R-Mutura/Qi_charger_mini/IMAGES/image 3.png

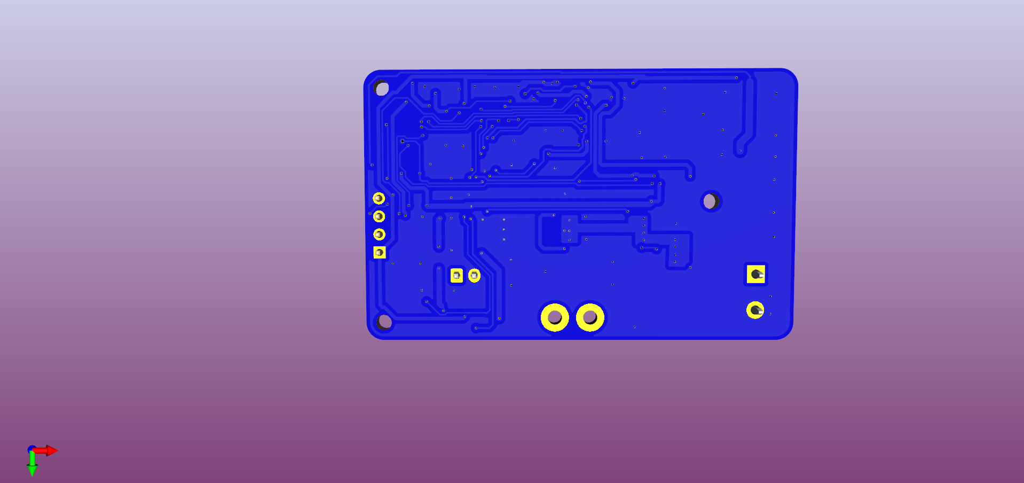
IMAGES/image 3.png
