R-Mutura/Qi_charger_mini/IMAGES/image 4.png

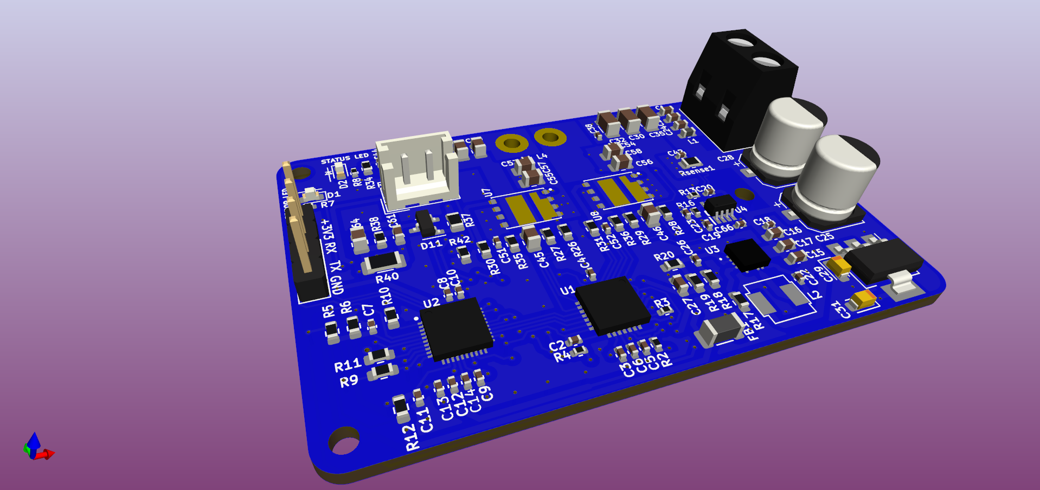
IMAGES/image 4.png
