R-Mutura/Qi_charger_mini/README.md

# The_Qi_wireless_charger_tx
This repo contains the design files for the Qi wireless charger.
