R-Mutura/Qi_charger_mini/FILES/recomended TX Coil.PNG

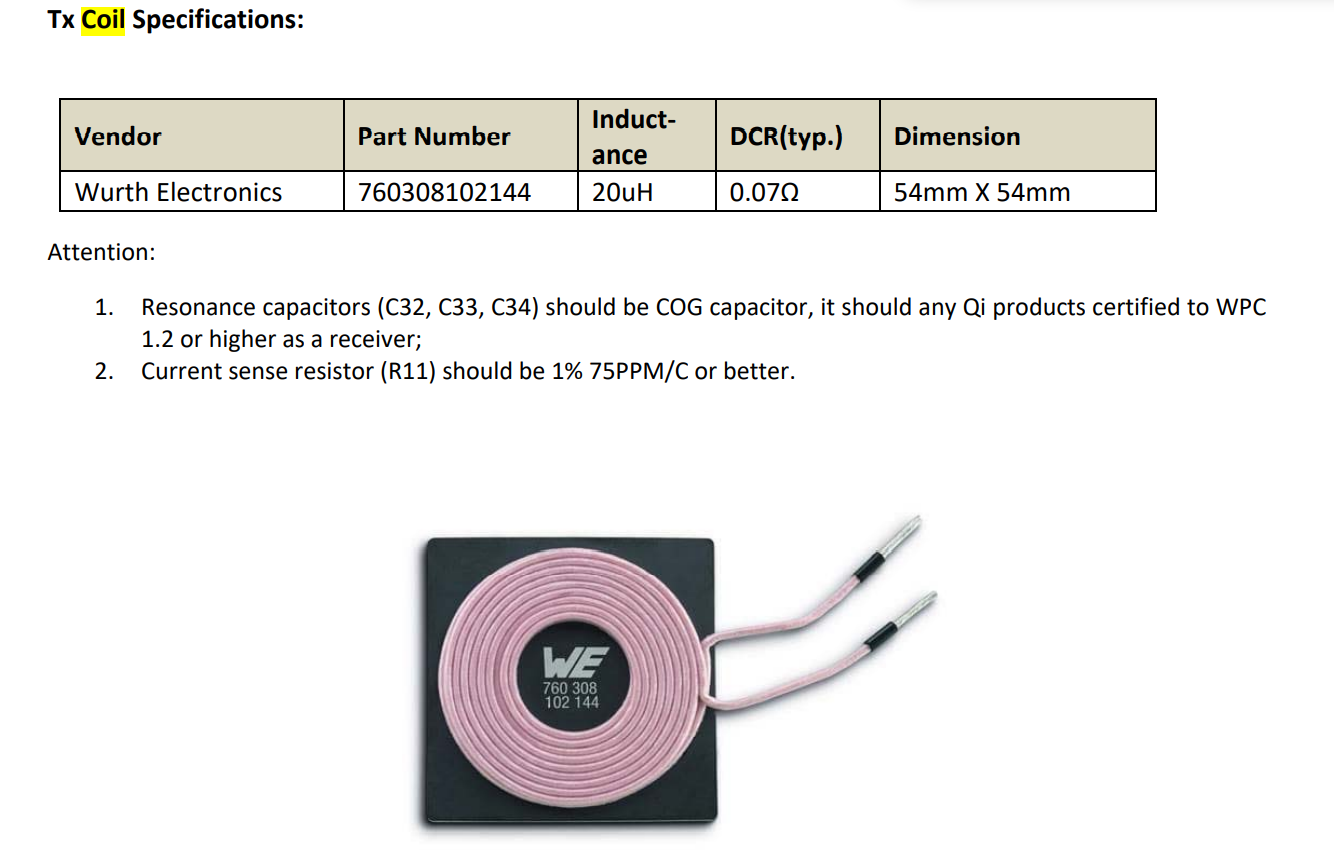
FILES/recomended TX Coil.PNG
