R-Mutura/Qi_charger_mini/IMAGES/image 1.png

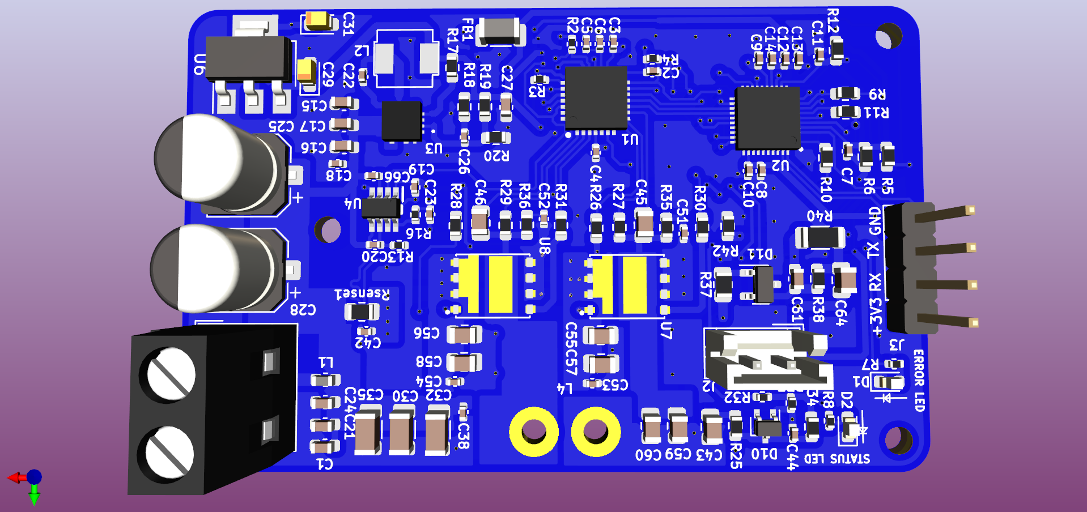
IMAGES/image 1.png
