R-Mutura/Qi_charger_mini/IMAGES/image 2.png

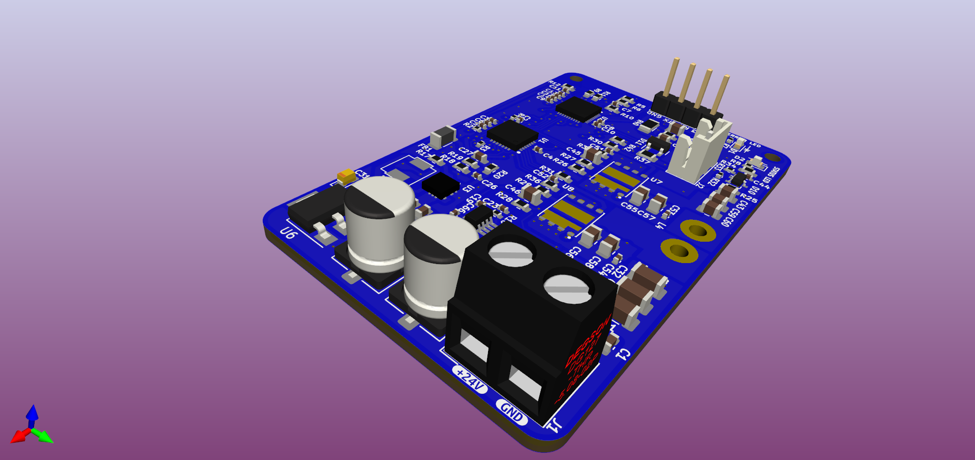
IMAGES/image 2.png
