R-Mutura/Qi_charger_mini/IMAGES/layout 1.PNG

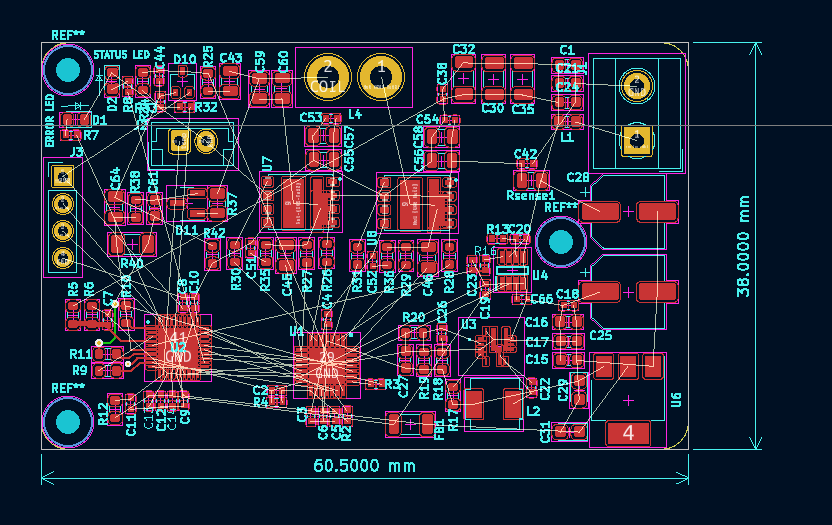
IMAGES/layout 1.PNG
