R-Mutura/Qi_charger_mini/BOM/Qi_wireless_charger_BOM(1).xlsx

Reference | Value | Footprint | MPN | Vendor | QTY
C1, C21 | 100nF | Capacitor_SMD:C_0603_1608Metric | 0603B104K500NT | LCSC | 2
C2 | 47pF | Capacitor_SMD:C_0402_1005Metric | CC0402JRNPO9BN470 | LCSC | 1
C4, C9-C11, C13, C14, C23 | 100nF | Capacitor_SMD:C_0402_1005Metric | CC0402JRNPO9BN470 | LCSC | 7
C5, C7, C8, C12 | 4.7uF | Capacitor_SMD:C_0402_1005Metric | CL05A475KP5NRNC | LCSC | 4
C3, C6, C66 | 10nF | Capacitor_SMD:C_0402_1005Metric | CL05B103KB5NNNC | LCSC | 3
C15-C17 | 4.7uF | Capacitor_SMD:C_0603_1608Metric | CL10A475KL8NRNC | LCSC | 3
C18 | 100nF_20mOHM | Capacitor_SMD:C_0402_1005Metric | CC0402JRNPO9BN470 | DigiKey | 1
C19 | 10nF_10V | Capacitor_SMD:C_0402_1005Metric | CL05B103KB5NNNC | LCSC | 1
C20 | 1uF | Capacitor_SMD:C_0402_1005Metric | CL05A105KP5NNNC | LCSC | 1
C22 | 100nF_1mOHM | Capacitor_SMD:C_0402_1005Metric | CC0402KRX7R7BB104 | LCSC | 1
C24 | 10nF | Capacitor_SMD:C_0603_1608Metric | 0603B104K500NT | LCSC | 1
C26 | 100pF | Capacitor_SMD:C_0402_1005Metric | CC0402KRX7R7BB104 | LCSC | 1
C27 | 47uF_3.70mOHM | Capacitor_SMD:C_0603_1608Metric | GRM188R60J476ME15D | LCSC | 1
C25, C28 | 100uF | Capacitor_SMD:CP_Elec_6.3x7.7 | VZT101M1HTR-0607 | LCSC | 2
C29, C31 | 10uF | Capacitor_Tantalum_SMD:CP_EIA-2012-12_Kemet-R | TAJR106K006RNJ | LCSC | 2
C30, C32, C35 | 22uF_35V | Capacitor_SMD:C_1206_3216Metric | C3216X5R1V226MTJ00E | LCSC | 3
C38, C53, C54 | 100nF_50V | Capacitor_SMD:C_0402_1005Metric | 0402F104M500NT | LCSC | 3
C42 | 100nF>50V | Capacitor_SMD:C_0402_1005Metric | 0402F104M500NT | LCSC | 1
C43 | 4.7nF_150V | Capacitor_SMD:C_0805_2012Metric | C0805C472K2RECAUTO | DigiKey | 1
C44 | 33pF | Capacitor_SMD:C_0402_1005Metric | CC0805JRNPOABN330 | DigiKey | 1
C51, C52 | 2.7nF | Capacitor_SMD:C_0402_1005Metric | 0402B272K500NT | LCSC | 2
C55-C58 | 22uF_35V | Capacitor_SMD:C_0805_2012Metric | C3216X5R1V226MTJ00E | LCSC | 4
C45, C46, C59, C60 | 47nF_250V | Capacitor_SMD:C_0805_2012Metric | C2012X7T2E473KT000N | LCSC | 4
C61 | 1nF_150V | Capacitor_SMD:C_0603_1608Metric | 0603B102K201CT | LCSC | 1
C64 | 100nF_150V | Capacitor_SMD:C_0805_2012Metric | FM21X104K201ECG | LCSC | 1
D1 | LED_RED | LED_SMD:LED_0603_1608Metric | SZYY0603R | LCSC | 1
D2 | LED_GREEN | LED_SMD:LED_0603_1608Metric | XZVGMDK53W-9 | LCSC | 1
D10 | BAT54SW_SERIES | Package_TO_SOT_SMD:SOT-323_SC-70 | BAT60B | LCSC | 1
D11 | MMBD7000HS | Package_TO_SOT_SMD:SOT-23 | MMBD7000HS | DigiKey | 1
FB1 | MLB3216-600P4A(f)_1206 | Inductor_SMD:L_1206_3216Metric | MLB3216-600P4A(f) | LCSC | 1
J1 | Screw_Terminal_01x02 | TerminalBlock_MetzConnect:TerminalBlock_MetzConnect_Type101_RT01602HBWC_1x02_P5.08mm_Horizontal | DB128L-5.08-2P-GN-P | LCSC | 1
J2 | THERMISTER_TEMP_IN | Connector_JST:JST_EH_B2B-EH-A_1x02_P2.50mm_Vertical | B2B-XH-A(LF)(SN) |  | 1
J3 | UART_SERIAL_CONN | Connector_PinHeader_2.54mm:PinHeader_1x04_P2.54mm_Vertical | B-2100S04P-A110 | LCSC | 1
L1 | BLM18SN220TH1D | Inductor_SMD:L_0603_1608Metric | BLM18SN220TH1D | LCSC | 1
L2 | MWSA0402S-3R3MT | greencharge-footprints:MWSA0402-xxx | MWSA0402S-3R3MT | DigiKey | 1
R2, R32, R33 | 7.5K | Resistor_SMD:R_0402_1005Metric | RC-02W1003FT | LCSC | 3
R3, R4 | 100K | Resistor_SMD:R_0402_1005Metric | RS-06K1003FT | LCSC | 2
R5, R11 | 100K | Resistor_SMD:R_0603_1608Metric | RC0603FR-07100KL | LCSC | 2
R6 | 11.5K | Resistor_SMD:R_0603_1608Metric | 0603WAF1152T5E | LCSC | 1
R7, R8 | 150 | Resistor_SMD:R_0402_1005Metric | 0402WGF1500TCE | LCSC | 2
R10 | 47K | Resistor_SMD:R_0603_1608Metric | 0603WAF4702T5E | LCSC | 1
R13 | 10R | Resistor_SMD:R_0402_1005Metric | 0402WGF1000TCE | LCSC | 1
R16 | 1.37K | Resistor_SMD:R_0402_1005Metric | 0402WGF1371TCE | LCSC | 1
R17, R38 | 100K_1% | Resistor_SMD:R_0603_1608Metric | RC0603FR-07100KL | LCSC | 2
R18 | 20K | Resistor_SMD:R_0603_1608Metric | 0603WAF2002T5E | LCSC | 1
R19 | 73.2K | Resistor_SMD:R_0603_1608Metric | ERJ3EKF7322V | LCSC | 1
R12, R20 | 10K | Resistor_SMD:R_0603_1608Metric | RC0603JR-0710KL | LCSC | 2
R25 | 200K | Resistor_SMD:R_0603_1608Metric | RC0603FR-07200KL | LCSC | 1
R27, R29 | 1 ohm | Resistor_SMD:R_0603_1608Metric | 0603WAF100KT5E | LCSC | 2
R35, R36 | 2 ohm | Resistor_SMD:R_0603_1608Metric | 0603WAF200KT5E | LCSC | 2
R37 | 7.5K | Resistor_SMD:R_0805_2012Metric | 0805W8F7501T5E | LCSC | 1
R40 | 1.5K | Resistor_SMD:R_1206_3216Metric | 1206W4J0102T5E | LCSC | 1
R9, R26, R28, R30, R31, R34, R42 | 0Ohm | Resistor_SMD:R_0603_1608Metric | 0603WAF0000T5E | LCSC | 7
Rsense1 | 0.01R_1% | Resistor_SMD:R_0805_2012Metric | RTT03R010JTP | LCSC | 1
U1 | TS61002 | greencharge-footprints:QFN50P500X500X100-29N | TS61002-QFNR | Mouser | 1
U2 | TS80003 | greencharge-footprints:QFN40P500X500X90-41N-D | TS80003-QFNR | Mouser | 1
U3 | TPS56637RPAR | greencharge-footprints:TPS56637RPAR | TPS56637RPAR | Digipart | 1
U4 | TS94033 | greencharge-footprints:SOT65P280X145-8N | TS94033 | Digipart | 1
U6 | AMS1117-3.3 | Package_TO_SOT_SMD:SOT-223-3_TabPin2 | AMS1117-3.3 | LCSC | 1
U7, U8 | BSC0993ND | greencharge-footprints:BSC0993ND | BSC0993NDATMA1 | Mouser | 2
