R-Mutura/Qi_charger_mini/FILES/ITEMS_RECOMENDATION.xlsx

NAME/ITEM | MFR#1 | LINKS | PRICE | MFR#2 | LINK_2 | PRICE_2 | MFR#3 | LINK_3 | PRICE_3
DISPLAY | 5inch AMOLED Display | https://www.globalsources.com/AMOLED-display/5inch-AMOLED-Display-1163260034p.htm | 42/pcs | 5.5 inch AMOLED Screen MIPI flexible oled | https://www.alibaba.com/product-detail/Amoled-Mipi-5-5-Inch-AMOLED_11000000463560.html?s=p | 28 | OEM 5 inch AMOLED TFT module display | https://www.alibaba.com/product-detail/LCD-TFT-module-driver-board-7_1600217797913.html | 34.54
DISPLAY DRIVER(SPI-MIPI) | 1024x600 40PIN 50PIN IPS 7" | https://www.digipart.com/part/TC358768AXBG(EL) | 3.594
TRANSMIT COIL(RX) | Qi A10 | https://hartai.en.made-in-china.com/product/NKLJYDcBnCVA/China-Qi-A10-Wireless-Charger-Tx-Coil-for-Mobile-Phone-Wireless-Charger.html | 0.4/PCS (100PCS) | Wireless charger coil A5 A6 A11 for Vishay Dale Electronics | https://www.alibaba.com/product-detail/43mm-Wireless-charger-coil-A5-A6_60228736673.html | 0.01/PCS (1000) | YX-A11-R501000-R0807 | https://lcsc.com/product-detail/Wireless-Charging-Coils_CND-tek-YX-A11-R501000-R0807-BEIJIAO_C424428.html | 0.3463
RECEVE COIL(RX) | Square Rx Coil(A5) | https://kimchen8.en.made-in-china.com/product/uBcmjaAlYKht/China-Square-Rx-Coil-Antenna-Coil-for-Samsung-Charging-Receiver.html | 0.465/PCS (500PCS) | YX-A11-R501000-R0807 | https://lcsc.com/product-detail/Wireless-Charging-Coils_CND-tek-YX-A11-R501000-R0807-BEIJIAO_C424428.html | 0.3463 | Coil Qi A5 | https://www.alibaba.com/product-detail/Charging-Coil-Wireless-Wireless-Charge-Coil_60568841665.html?s=p | 0.01/PCS (100)
RECEVE COIL(RX) | Another square coil | https://m.made-in-china.com/product/Qi-WPC-Charger-Inductive-Small-Capacitance-Wireless-Charging-Receiver-Rx-Coil-787279135.html | 0.2/pcs (20pcs)
BATTERY | high capacity 1160100(10Ah) | https://www.alibaba.com/product-detail/high-capacity-1160100-10000mah-3-7v_60740948993.html | 6.99 | 1090100 1S2P LiPO | https://www.alibaba.com/product-detail/High-capacity-lipo-battery-1090100-1S2P_60861781658.html | 11.66 | 6000mah 3.7V 806090 | https://www.alibaba.com/product-detail/high-capacity-lithium-ion-battery-6000mah_1600089017174.html | 5(pieces min)
