R-Mutura/Qi_charger_mini/src_files(1)/src_files/The_Qi_wireless_charger_tx.kicad_pcb

## KiCad design src_files(1)/src_files/The_Qi_wireless_charger_tx.kicad_pcb (2022-05-29)

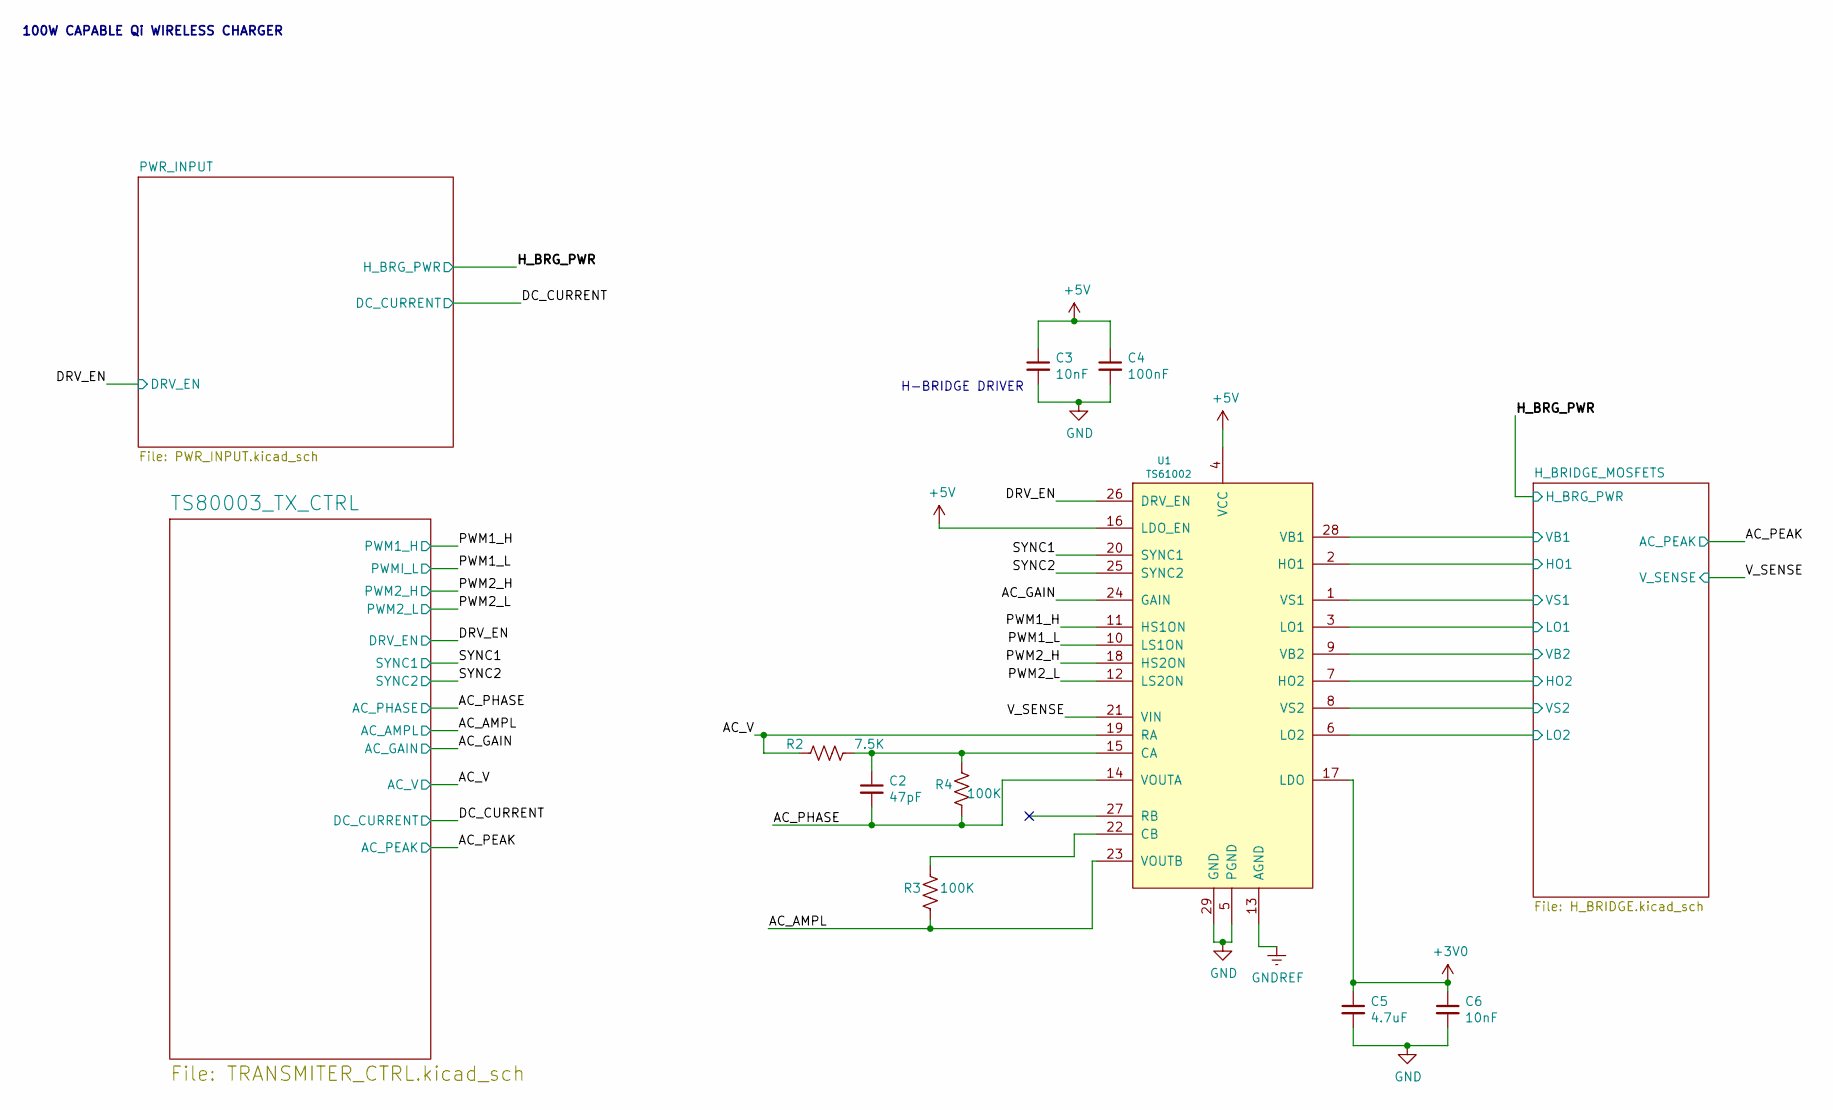
[picture p12: schematic The_Qi_wireless_charger_tx.kicad_sch]

Parts:
C2: 47pF; C_0402_1005Metric
C3, C6: 10nF; C_0402_1005Metric
C4: 100nF; C_0402_1005Metric
C5: 4.7uF; C_0402_1005Metric
R2: 7.5K; R_0402_1005Metric
R3, R4: 100K; R_0402_1005Metric
U1: TS61002; QFN50P500X500X100-29N

Connections:
+3V0: C5.1, C6.1, U1.17 (LDO)
+5V: C3.1, C4.1, U1.4 (VCC), U1.16 (LDO_EN); also elsewhere on the board
/AC_AMPL: R3.2, U1.23 (VOUTB); also elsewhere on the board
/AC_GAIN: U1.24 (GAIN); also elsewhere on the board
/AC_PHASE: C2.2, R4.2, U1.14 (VOUTA); also elsewhere on the board
/AC_V: R2.1, U1.19 (RA); also elsewhere on the board
/DRV_EN: U1.26 (DRV_EN); also elsewhere on the board
/H_BRIDGE_MOSFETS/HO1: U1.2 (HO1); also elsewhere on the board
/H_BRIDGE_MOSFETS/HO2: U1.7 (HO2); also elsewhere on the board
/H_BRIDGE_MOSFETS/LO1: U1.3 (LO1); also elsewhere on the board
/H_BRIDGE_MOSFETS/LO2: U1.6 (LO2); also elsewhere on the board
/H_BRIDGE_MOSFETS/VB1: U1.28 (VB1); also elsewhere on the board
/H_BRIDGE_MOSFETS/VB2: U1.9 (VB2); also elsewhere on the board
/H_BRIDGE_MOSFETS/VS1: U1.1 (VS1); also elsewhere on the board
/H_BRIDGE_MOSFETS/VS2: U1.8 (VS2); also elsewhere on the board
/PWM1_H: U1.11 (HS1ON); also elsewhere on the board
/PWM1_L: U1.10 (LS1ON); also elsewhere on the board
/PWM2_H: U1.18 (HS2ON); also elsewhere on the board
/PWM2_L: U1.12 (LS2ON); also elsewhere on the board
/SYNC1: U1.20 (SYNC1); also elsewhere on the board
/SYNC2: U1.25 (SYNC2); also elsewhere on the board
/V_SENSE: U1.21 (VIN); also elsewhere on the board
GND: C3.2, C4.2, C5.2, C6.2, U1.5 (PGND), U1.29 (GND); also elsewhere on the board
GNDREF: U1.13 (AGND); also elsewhere on the board
unnamed: C2.1, R2.2, R4.1, U1.15 (CA)
unnamed: R3.1, U1.22 (CB)

Notes on the sheet:
100W CAPABLE Qi WIRELESS CHARGER
H-BRIDGE DRIVER

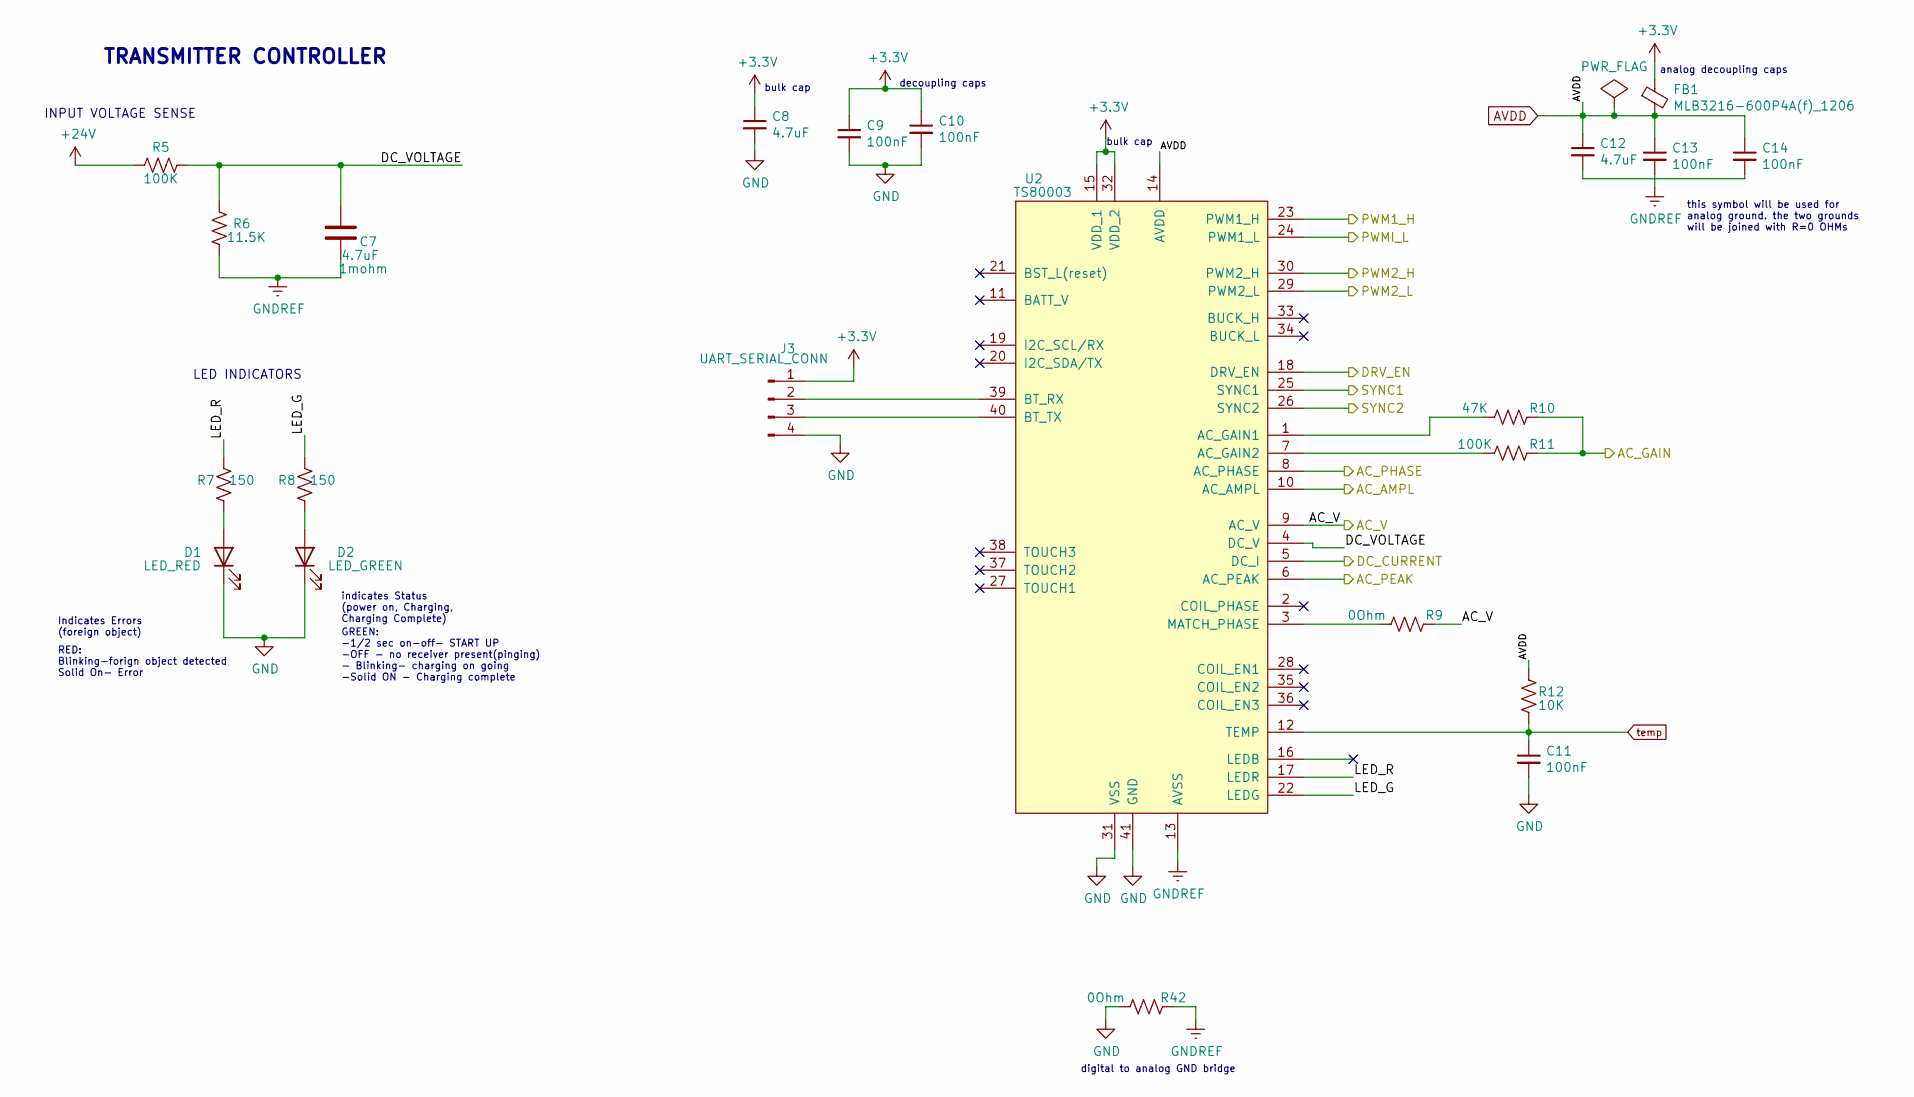
[picture p13: schematic TRANSMITER_CTRL.kicad_sch]

Parts:
C7, C8, C12: 4.7uF; C_0402_1005Metric
C9, C10, C11, C13, C14: 100nF; C_0402_1005Metric
D1: LED_RED; LED_0603_1608Metric
D2: LED_GREEN; LED_0603_1608Metric
FB1: MLB3216-600P4A(f)_1206; L_1206_3216Metric
J3: UART_SERIAL_CONN; PinHeader_1x04_P2.54mm_Vertical
R5, R11: 100K; R_0603_1608Metric
R6: 11.5K; R_0603_1608Metric
R7, R8: 150; R_0402_1005Metric
R9, R42: 0Ohm; R_0603_1608Metric
R10: 47K; R_0603_1608Metric
R12: 10K; R_0603_1608Metric
U2: TS80003; QFN40P500X500X90-41N-D

Connections:
+3V3: C8.1, C9.1, C10.1, FB1.1, J3.1, U2.15 (VDD_1), U2.32 (VDD_2); also elsewhere on the board
+24V: R5.2; also elsewhere on the board
/AC_AMPL: U2.10 (AC_AMPL); also elsewhere on the board
/AC_GAIN: R10.1, R11.1; also elsewhere on the board
/AC_PEAK: U2.6 (AC_PEAK); also elsewhere on the board
/AC_PHASE: U2.8 (AC_PHASE); also elsewhere on the board
/AC_V: R9.1, U2.9 (AC_V); also elsewhere on the board
/DC_CURRENT: U2.5 (DC_I); also elsewhere on the board
/DRV_EN: U2.18 (DRV_EN); also elsewhere on the board
/PWM1_H: U2.23 (PWM1_H); also elsewhere on the board
/PWM1_L: U2.24 (PWM1_L); also elsewhere on the board
/PWM2_H: U2.30 (PWM2_H); also elsewhere on the board
/PWM2_L: U2.29 (PWM2_L); also elsewhere on the board
/SYNC1: U2.25 (SYNC1); also elsewhere on the board
/SYNC2: U2.26 (SYNC2); also elsewhere on the board
/TS80003_TX_CTRL/DC_VOLTAGE: C7.1, R5.1, R6.2, U2.4 (DC_V)
/TS80003_TX_CTRL/LED_G: R8.1, U2.22 (LEDG)
/TS80003_TX_CTRL/LED_R: R7.1, U2.17 (LEDR)
AVDD: C12.1, C13.1, C14.1, FB1.2, R12.1, U2.14 (AVDD); also elsewhere on the board
GND: C8.2, C9.2, C10.2, C11.2, D1.1 (K), D2.1 (K), J3.4, R42.2, U2.31 (VSS), U2.41 (GND); also elsewhere on the board
GNDREF: C7.2, C13.2, R6.1, R42.1, U2.13 (AVSS); also elsewhere on the board
unnamed: C12.2, C14.2
unnamed: D1.2 (A), R7.2
unnamed: D2.2 (A), R8.2
unnamed: J3.2, U2.39 (BT_RX)
unnamed: J3.3, U2.40 (BT_TX)
unnamed: R9.2, U2.3 (MATCH_PHASE)
unnamed: R10.2, U2.1 (AC_GAIN1)
unnamed: R11.2, U2.7 (AC_GAIN2)
temp: C11.1, R12.2, U2.12 (TEMP); also elsewhere on the board

Notes on the sheet:
TRANSMITTER CONTROLLER
INPUT VOLTAGE SENSE
indicates Status (power on, Charging, Charging Complete)
digital to analog GND bridge
LED INDICATORS
analog decoupling caps
this symbol will be used for analog ground. the two grounds will be joined with R=0 OHMs
bulk cap
RED: Blinking-forign object detected Solid On- Error
decoupling caps
GREEN: -1/2 sec on-off- START UP -OFF - no receiver present(pinging) - Blinking- charging on going -Solid ON - Charging complete
Indicates Errors (foreign object)

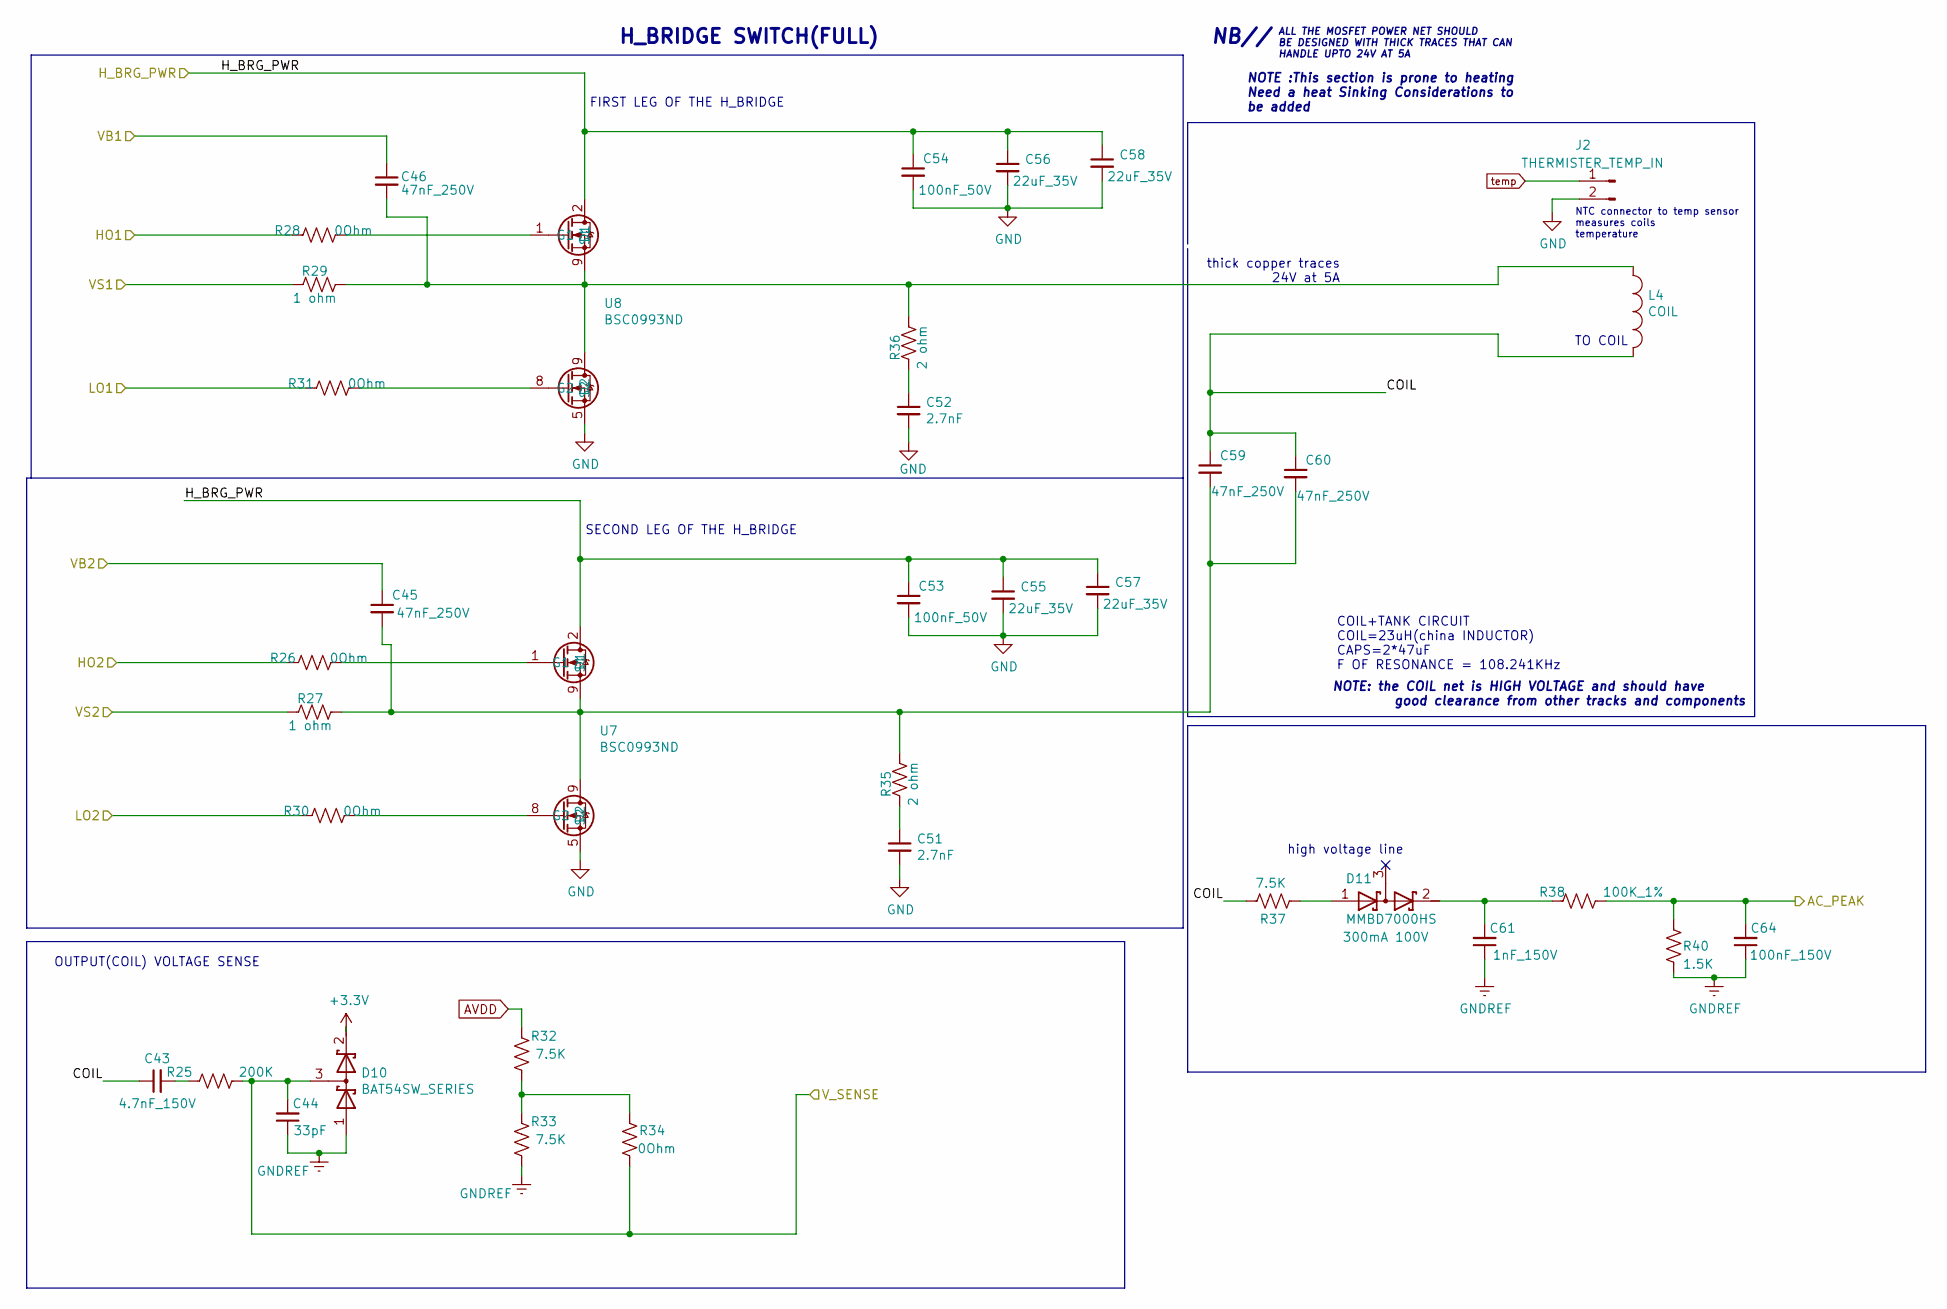
[picture p14: schematic H_BRIDGE.kicad_sch]

Parts:
C43: 4.7nF_150V; C_0805_2012Metric
C44: 33pF; C_0402_1005Metric
C45, C46, C59, C60: 47nF_250V; C_0805_2012Metric
C51, C52: 2.7nF; C_0402_1005Metric
C53, C54: 100nF_50V; C_0402_1005Metric
C55, C56, C57, C58: 22uF_35V; C_0805_2012Metric
C61: 1nF_150V; C_0603_1608Metric
C64: 100nF_150V; C_0805_2012Metric
D10: BAT54SW_SERIES; SOT-323_SC-70
D11: MMBD7000HS; SOT-23
J2: THERMISTER_TEMP_IN; JST_EH_B2B-EH-A_1x02_P2.50mm_Vertical
L4: COIL; coil_760308102144
R25: 200K; R_0603_1608Metric
R26, R28, R30, R31, R34: 0Ohm; R_0603_1608Metric
R27, R29: 1 ohm; R_0603_1608Metric
R32, R33: 7.5K; R_0402_1005Metric
R35, R36: 2 ohm; R_0603_1608Metric
R37: 7.5K; R_0805_2012Metric
R38: 100K_1%; R_0603_1608Metric
R40: 1.5K; R_1206_3216Metric
U7, U8: BSC0993ND

Connections:
+3V3: D10.2 (K); also elsewhere on the board
/AC_PEAK: C64.2, R38.2, R40.2; also elsewhere on the board
/H_BRG_PWR: C53.1, C54.1, C55.1, C56.1, C57.1, C58.1, U7.2 (D1), U7.3 (D1), U7.4 (D1), U8.2 (D1), U8.3 (D1), U8.4 (D1); also elsewhere on the board
/H_BRIDGE_MOSFETS/COIL: C43.1, C59.1, C60.1, L4.2, R37.1
/H_BRIDGE_MOSFETS/HO1: R28.1; also elsewhere on the board
/H_BRIDGE_MOSFETS/HO2: R26.1; also elsewhere on the board
/H_BRIDGE_MOSFETS/LO1: R31.1; also elsewhere on the board
/H_BRIDGE_MOSFETS/LO2: R30.1; also elsewhere on the board
/H_BRIDGE_MOSFETS/VB1: C46.1; also elsewhere on the board
/H_BRIDGE_MOSFETS/VB2: C45.1; also elsewhere on the board
/H_BRIDGE_MOSFETS/VS1: R29.2; also elsewhere on the board
/H_BRIDGE_MOSFETS/VS2: R27.2; also elsewhere on the board
/V_SENSE: C44.2, D10.3 (common), R25.2, R34.1; also elsewhere on the board
AVDD: R32.2; also elsewhere on the board
GND: C51.2, C52.2, C53.2, C54.2, C55.2, C56.2, C57.2, C58.2, J2.2, U7.5 (S2), U7.6 (S2), U7.7 (S2), U8.5 (S2), U8.6 (S2), U8.7 (S2); also elsewhere on the board
GNDREF: C44.1, C61.1, C64.1, D10.1 (A), R33.1, R40.1; also elsewhere on the board
unnamed: C43.2, R25.1
unnamed: C45.2, C59.2, C60.2, R27.1, R35.1, U7.9 (S1)
unnamed: C46.2, L4.1, R29.1, R36.1, U8.9 (S1)
unnamed: C51.1, R35.2
unnamed: C52.1, R36.2
unnamed: C61.2, D11.2 (K), R38.1
unnamed: D11.1 (A), R37.2
unnamed: R26.2, U7.1 (G1)
unnamed: R28.2, U8.1 (G1)
unnamed: R30.2, U7.8 (G2)
unnamed: R31.2, U8.8 (G2)
unnamed: R32.1, R33.2, R34.2
temp: J2.1; also elsewhere on the board

Notes on the sheet:
H_BRIDGE SWITCH(FULL)
COIL+TANK CIRCUIT COIL=23uH(china INDUCTOR) CAPS=2*47uF F OF RESONANCE = 108.241KHz
NOTE :This section is prone to heating Need a heat Sinking Considerations to be added
NOTE: the COIL net is HIGH VOLTAGE and should have good clearance from other tracks and components
FIRST LEG OF THE H_BRIDGE
NTC connector to temp sensor measures coils temperature
ALL THE MOSFET POWER NET SHOULD BE DESIGNED WITH THICK TRACES THAT CAN HANDLE UPTO 24V AT 5A
NB//
thick copper traces 24V at 5A
OUTPUT(COIL) VOLTAGE SENSE
high voltage line
TO COIL
SECOND LEG OF THE H_BRIDGE

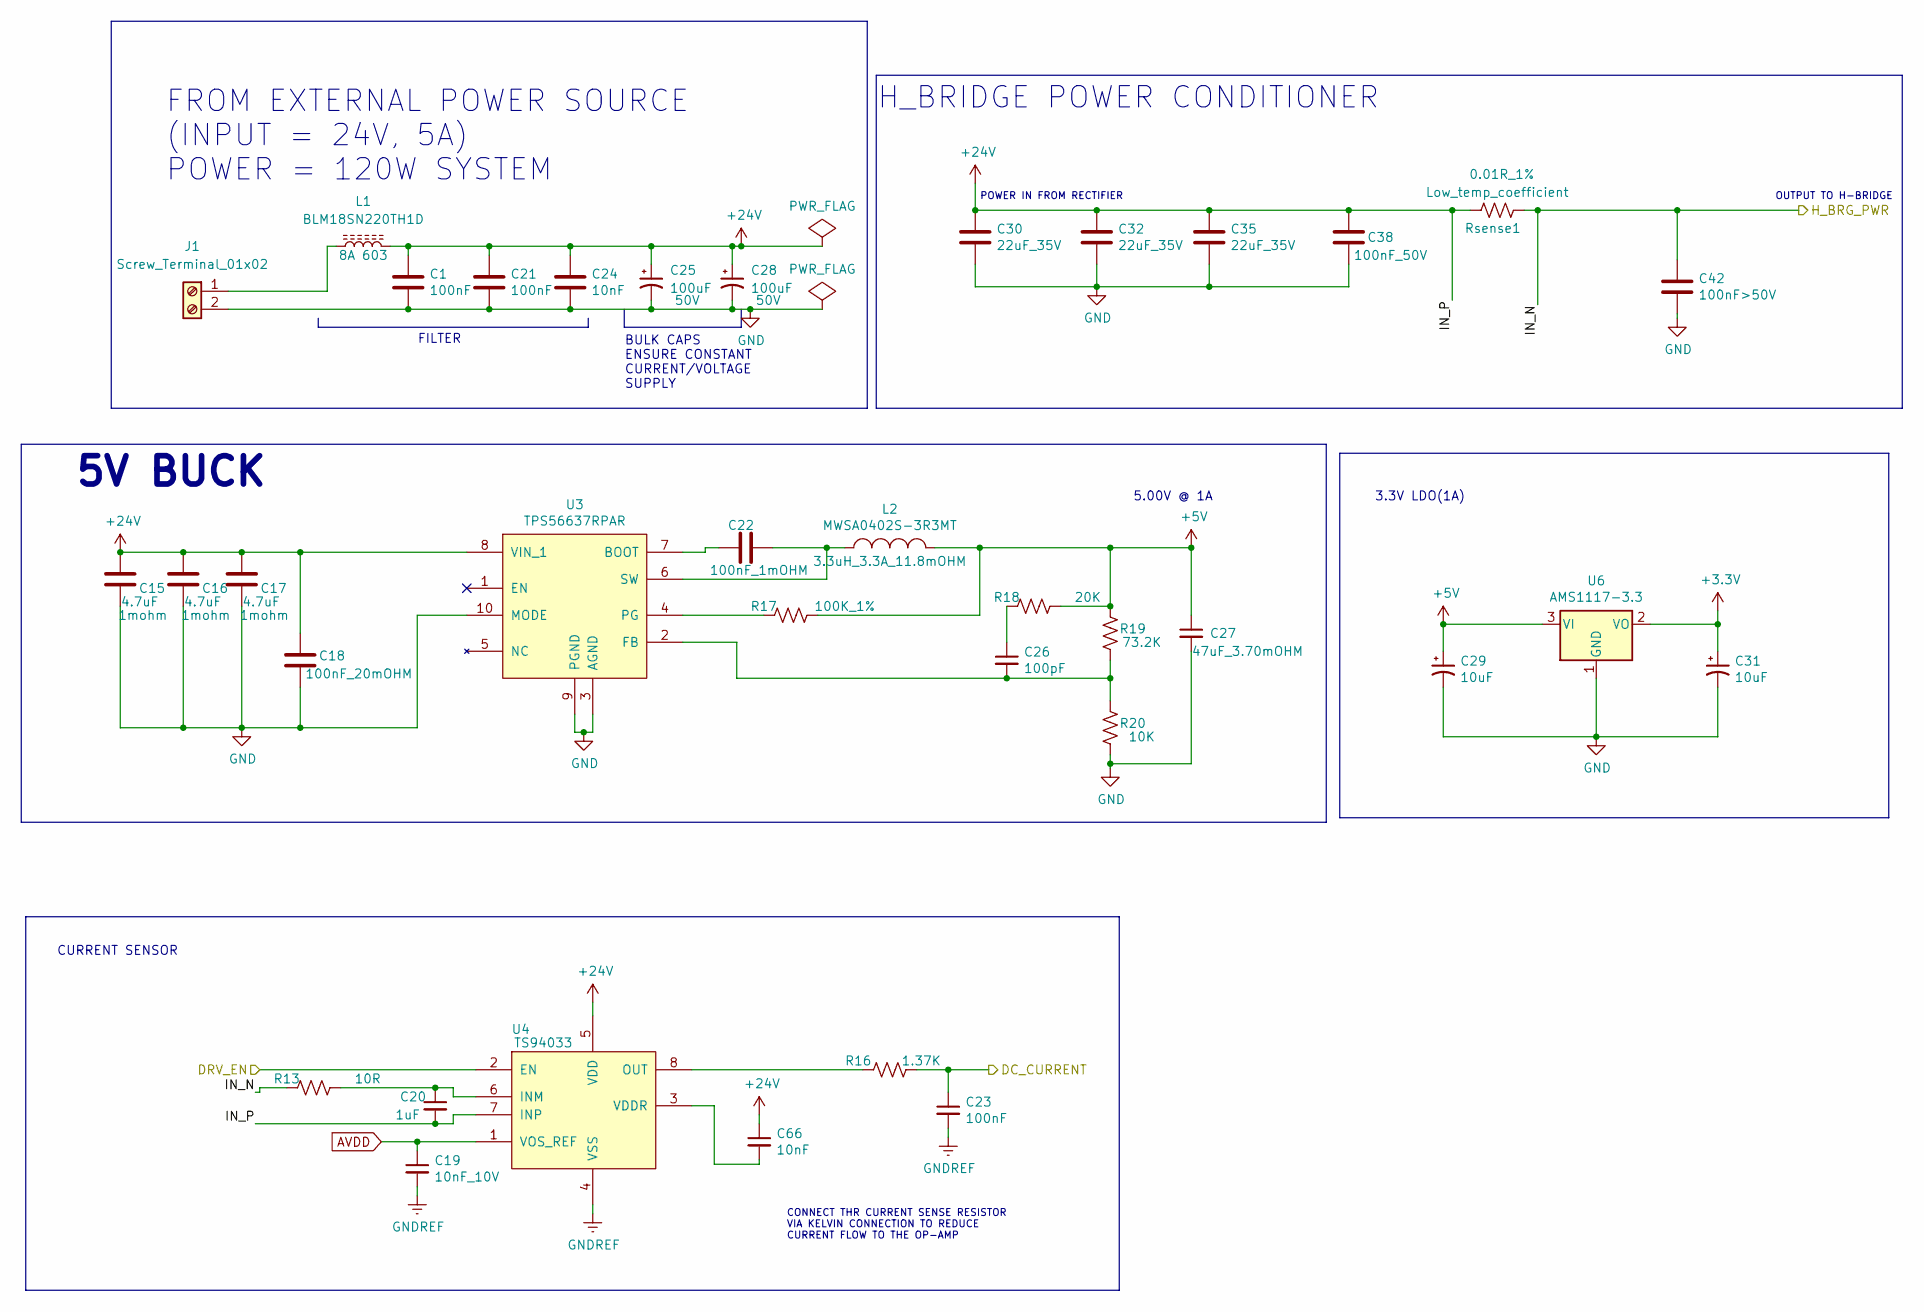
[picture p15: schematic PWR_INPUT.kicad_sch]

Parts:
C1, C21: 100nF; C_0603_1608Metric
C15, C16, C17: 4.7uF; C_0603_1608Metric
C18: 100nF_20mOHM; C_0402_1005Metric
C19: 10nF_10V; C_0402_1005Metric
C20: 1uF; C_0402_1005Metric
C22: 100nF_1mOHM; C_0402_1005Metric
C23: 100nF; C_0402_1005Metric
C24: 10nF; C_0603_1608Metric
C25, C28: 100uF; CP_Elec_6.3x7.7; MPN VZT101M1HTR-0607
C26: 100pF; C_0402_1005Metric
C27: 47uF_3.70mOHM; C_0603_1608Metric
C29, C31: 10uF; CP_EIA-2012-12_Kemet-R
C30, C32, C35: 22uF_35V; C_1206_3216Metric
C38: 100nF_50V; C_0402_1005Metric
C42: 100nF>50V; C_0402_1005Metric
C66: 10nF; C_0402_1005Metric
J1: Screw_Terminal_01x02; TerminalBlock_MetzConnect_Type101_RT01602HBWC_1x02_P5.08mm_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
L1: BLM18SN220TH1D; L_0603_1608Metric
L2: MWSA0402S-3R3MT; MWSA0402-xxx
R13: 10R; R_0402_1005Metric
R16: 1.37K; R_0402_1005Metric
R17: 100K_1%; R_0603_1608Metric
R18: 20K; R_0603_1608Metric
R19: 73.2K; R_0603_1608Metric
R20: 10K; R_0603_1608Metric
Rsense1: 0.01R_1%; R_0805_2012Metric
U3: TPS56637RPAR
U4: TS94033; SOT65P280X145-8N
U6: AMS1117-3.3; SOT-223-3_TabPin2

Connections:
+3V3: C31.1, U6.2 (VO); also elsewhere on the board
+5V: C27.1, C29.1, L2.2, R17.2, R18.2, R19.2, U6.3 (VI); also elsewhere on the board
+24V: C1.1, C15.1, C16.1, C17.1, C18.1, C20.2, C21.1, C24.1, C25.1, C28.1, C30.1, C32.1, C35.1, C38.1, C66.1, L1.2, Rsense1.1, U3.8 (VIN_1), U3.11 (VIN_2), U3.12 (VIN_3), U3.13 (VIN_4), U4.5 (VDD), U4.7 (INP); also elsewhere on the board
/DC_CURRENT: C23.1, R16.1; also elsewhere on the board
/DRV_EN: U4.2 (EN); also elsewhere on the board
/H_BRG_PWR: C42.1, R13.1, Rsense1.2; also elsewhere on the board
AVDD: C19.1, U4.1 (VOS_REF); also elsewhere on the board
GND: C1.2, C15.2, C16.2, C17.2, C18.2, C21.2, C24.2, C25.2, C27.2, C28.2, C29.2, C30.2, C31.2, C32.2, C35.2, C38.2, C42.2, J1.2, R20.1, U3.3 (AGND), U3.9 (PGND), U3.10 (MODE), U6.1 (GND); also elsewhere on the board
GNDREF: C19.2, C23.2, U4.4 (VSS); also elsewhere on the board
unnamed: C20.1, R13.2, U4.6 (INM)
unnamed: C22.1, U3.7 (BOOT)
unnamed: C22.2, L2.1, U3.6 (SW)
unnamed: C26.1, R18.1
unnamed: C26.2, R19.1, R20.2, U3.2 (FB)
unnamed: C66.2, U4.3 (VDDR)
unnamed: J1.1, L1.1
unnamed: R16.2, U4.8 (OUT)
unnamed: R17.1, U3.4 (PG)

Notes on the sheet:
OUTPUT TO H-BRIDGE
5.00V @ 1A
BULK CAPS ENSURE CONSTANT CURRENT/VOLTAGE SUPPLY
POWER IN FROM RECTIFIER
FROM EXTERNAL POWER SOURCE (INPUT = 24V, 5A) POWER = 120W SYSTEM
FILTER
H_BRIDGE POWER CONDITIONER
CONNECT THR CURRENT SENSE RESISTOR VIA KELVIN CONNECTION TO REDUCE CURRENT FLOW TO THE OP-AMP
3.3V LDO(1A)
5V BUCK
CURRENT SENSOR

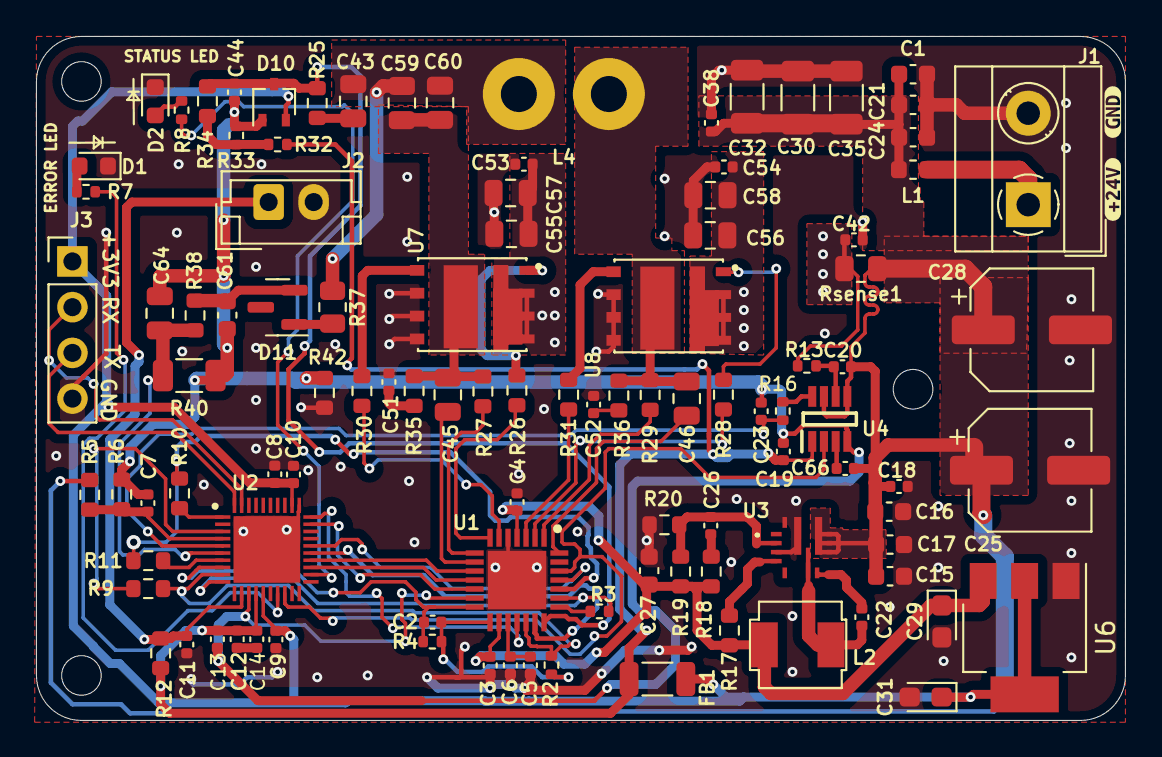
[picture p16: board The_Qi_wireless_charger_tx.kicad_pcb from above]

Board: 2 copper layers, 60.5 x 38.0 mm, 106 parts (0 on the bottom side), 66 nets.

Other parts of the board:
kibuzzard-628BC247: G***; kibuzzard-628BC247
kibuzzard-628BC257: G***; kibuzzard-628BC257
